Pasqalup/RS485-modules/code/slave/readme.md

# CH32V003 Slave Code
Template code for CH32V003 slave modules
## Compiling
This is coded for cnlohr's [ch32fun](https://github.com/cnlohr/ch32fun/)
1. Clone [ch32fun](https://github.com/cnlohr/ch32fun/) repository:
```
git clone https://github.com/cnlohr/ch32fun/
``` 
2. Create a new folder in the examples directory: 
```
mkdir ch32fun/examples/rs485slave/
cd ch32fun/examples/rs485slave/
```
3. Copy all files from here into the new project directory:
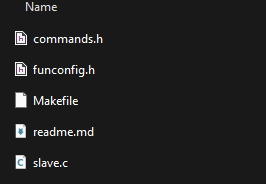
[picture p6: assets/slave_code.png]
funconfig.h Makefile slave.c

4. Compile 
```
make
```

## Notes
* If ch32fun's minichlink isn't working, download the [WCH-LinkUtility](https://www.wch.cn/downloads/WCH-LinkUtility_ZIP.html) with core set to RISC-V, series set to CH32V003, and target file to the compiled .hex file
