Pasqalup/RS485-modules/pcbs/servo module/Servo module.png

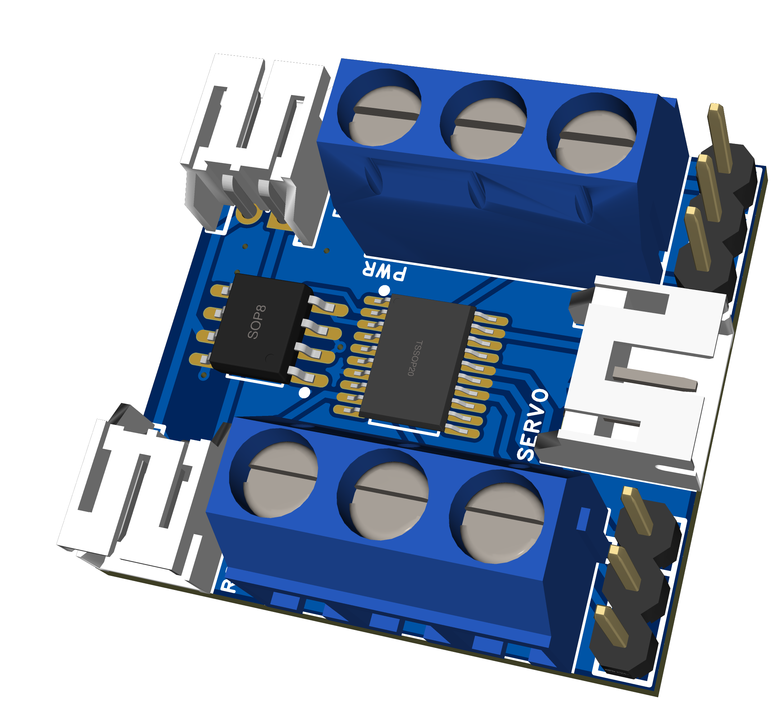
pcbs/servo module/Servo module.png
