Pasqalup/RS485-modules/(list of files, drawings)

Other design files:
pcbs/master/Master board.epro
pcbs/servo module/Servo module.epro
