Pasqalup/RS485-modules/(commit log)

2026-03-30 Add master board
    [Master board.epro]
2026-04-03 Update PCB
    [BOM.csv, Master board.epro]
2026-04-03 Update README for clarity and additional references
    Improved clarity and added references to coding and master board pages.
2026-04-03 Enhance README with assembly instructions
    Added assembly instructions for soldering components.
